Qrist0ph/jiotty_wled_pcb_controller/wled_pcb_controller/README.md

# jiotty_wled_pcb_controller
 
Design based on [https://github.com/klein0r/pcb-ws2812-wifi-controller](https://github.com/klein0r/pcb-ws2812-wifi-controller)
