Qrist0ph/jiotty_wled_pcb_controller/jiottywledtscew/3D1.png

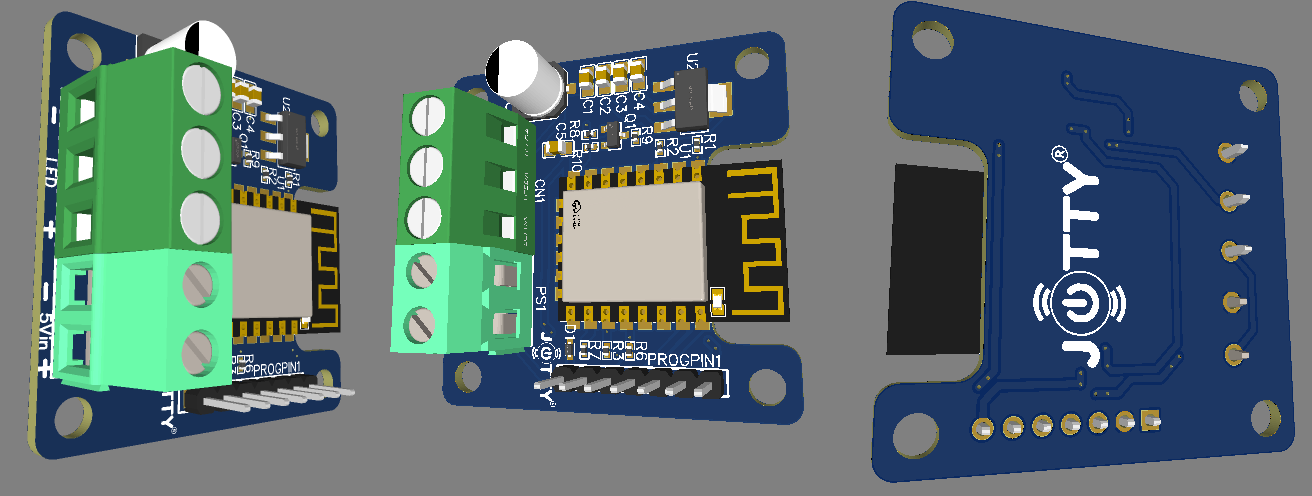
jiottywledtscew/3D1.png
