Qrist0ph/jiotty_wled_pcb_controller/jiottywledusb/3D2.png

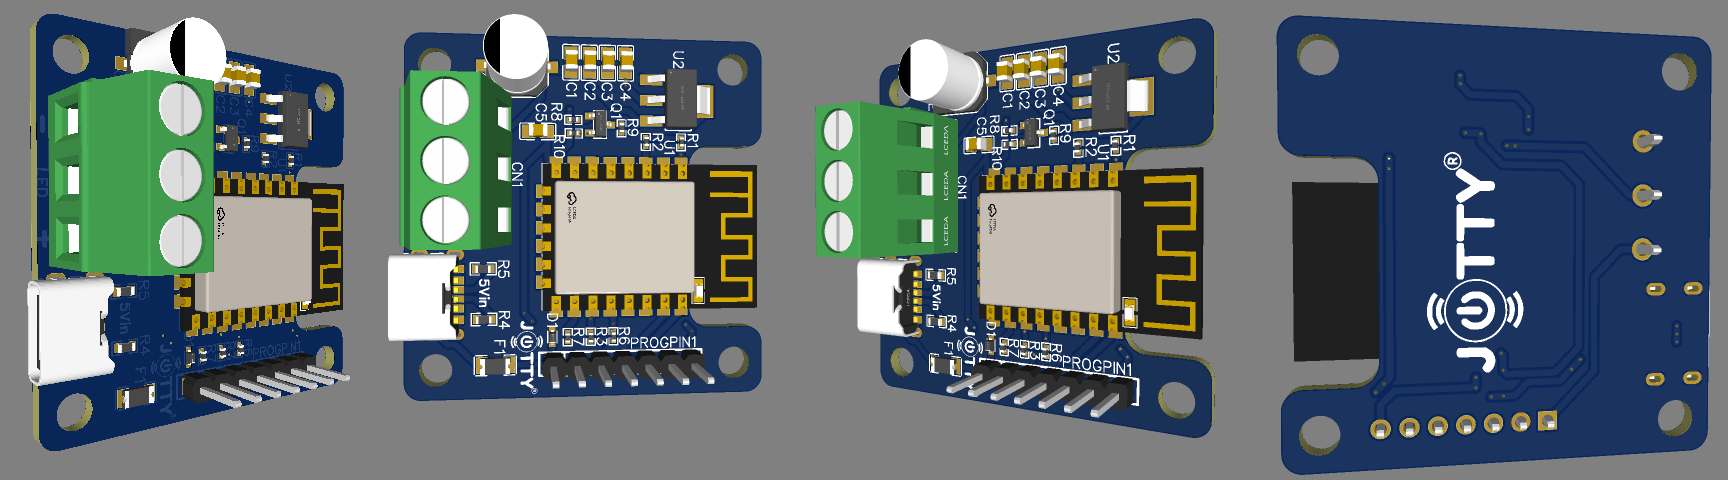
jiottywledusb/3D2.png
