Qrist0ph/jiotty_wled_pcb_controller/jiottywledusb/BOM_PCB_qrist0pf_Proj3_LED_USBScrew_2023-04-06.csv

ID | Name | Designator | Footprint | Quantity | Manufacturer Part | Manufacturer | Supplier | Supplier Part | Price
1 | JK-NSMD200/6V | F1 | F1206 | 1 | JK-nSMD200/6V | JK(金科) | LCSC | C2830251 | 0.006
2 | 5.1kΩ | R4,R5 | R0603 | 2 | 0603WAF5101T5E | UNI-ROYAL(厚声) | LCSC | C23186
3 | TYPE-C-31-M-17 | USB1 | USB-C-SMD_10P-P1.00-L6.8-W8.9 | 1 | TYPE-C-31-M-17 | 韩国韩荣 | LCSC | C283540 | 0.035
4 | WJ500V-5.08-3P-14-00A | CN1 | CONN-TH_3P-P5.00_WJ500V-5.08-3P | 1 | WJ500V-5.08-3P | KANGNEX(康奈克斯电气) | LCSC | C72334 | 0.026
5 | MMBT5551 | Q1 | SOT-23-3_L2.9-W1.3-P1.90-LS2.4-BR | 1 | MMBT5551 | CJ | LCSC | C2145 | 0.002
6 | 1kΩ | R8 | R0402 | 1 | 0402WGF1001TCE | UniOhm | LCSC | C11702
7 | 10kΩ | R9,R10 | R0402 | 2 | 0402WGF1002TCE | UniOhm | LCSC | C25744
8 | 47uF | C1,C3 | C0805 | 2 | CL21A476MQYNNNE | SAMSUNG(三星) | LCSC | C16780 | 0.004
9 | 100nF | C2,C4,C5 | C0805 | 3 | CC0805KRX7R9BB104 | YAGEO | LCSC | C49678 | 0.001
10 | 220uF | CE1 | CAP-SMD_BD6.3-L6.6-W6.6-LS7.2-FD | 1 | RVT1A221M0607 | HONOR | LCSC | C87859 | 0.008
11 | LESD5D5.0CT1G | D1 | SOD-523_L1.2-W0.8-LS1.6-BI | 1 | LESD5D5.0CT1G | Leshan Radio | LCSC | C383211 | 0.003
12 | PZ254V-11-07P | PROGPIN1 | HDR-TH_7P-P2.54-V-M | 1 | PZ254V-11-07P | XFCN(兴飞) | LCSC | C492406 | 0.006
13 | 10kΩ | R1,R2,R3,R6,R7 | R0402 | 5 | 0402WGF1002TCE | UNI-ROYAL(厚声) | LCSC | C25744
14 | 2.4GHz | U1 | WIFIM-SMD_ESP-12F-ESP8266MOD | 1 | ESP-12F(ESP8266MOD) | Ai-Thinker(安信可) | LCSC | C82891 | 0.361
15 | AMS1117-3.3 | U2 | SOT-223-3_L6.5-W3.4-P2.30-LS7.0-BR | 1 | AMS1117-3.3 | AMS | LCSC | C6186 | 0.024
