Qrist0ph/jiotty_wled_pcb_controller/jiottywledusb/PCB_qrist0pf_Proj3_LED_USBScrew_2023-04-06.dxf

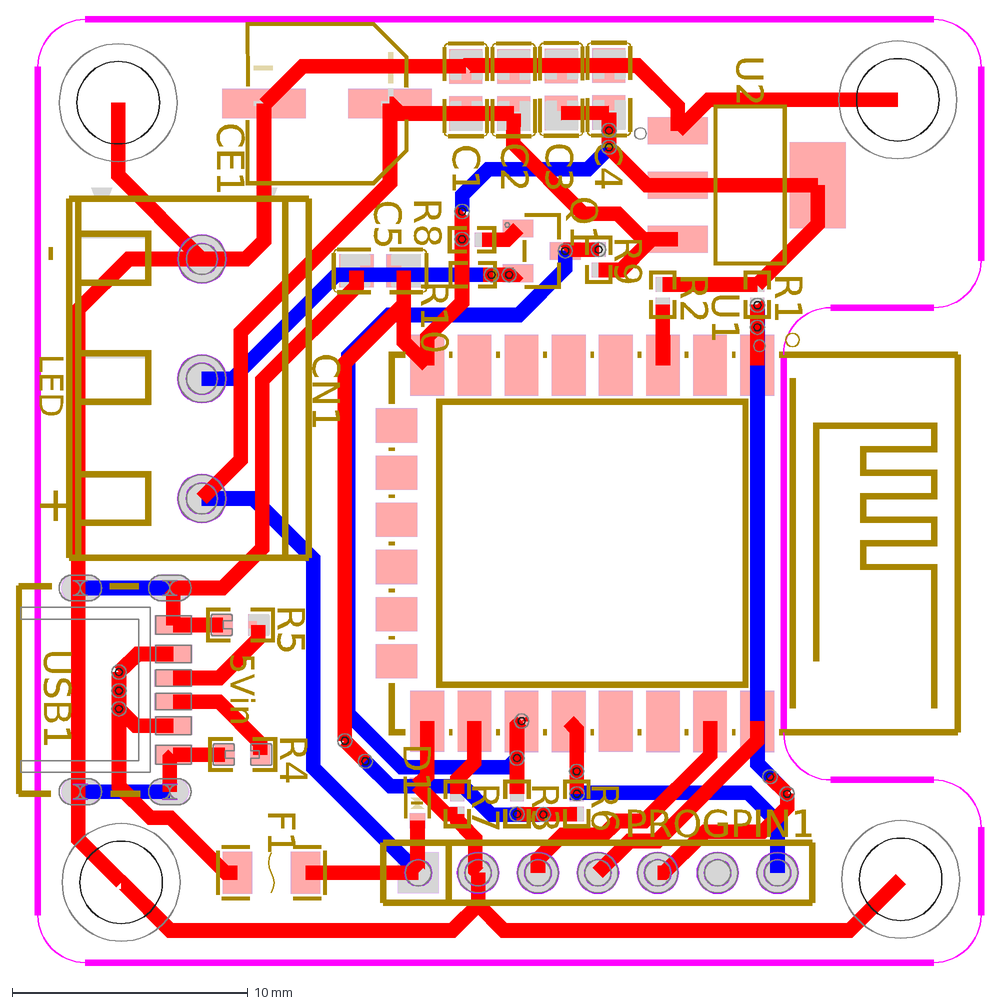
[picture p5: CAD file, 2023-05-03]
jiottywledusb/PCB_qrist0pf_Proj3_LED_USBScrew_2023-04-06.dxf
-
LED
+
5Vin
F1
R4
R5
USB1
CN1
Q1
R8
R9
R10
C1
C2
C3
C4
C5
CE1
D1
PROGPIN1
R1
R2
R3
R6
R7
U1
U2
