Qrist0ph/jiotty_wled_pcb_controller/jiottywledtscew/Schematic_qrist0pf_Proj3_LED_2023-04-06.pdf

## Resettable FUSE 2.0A

2 | OR

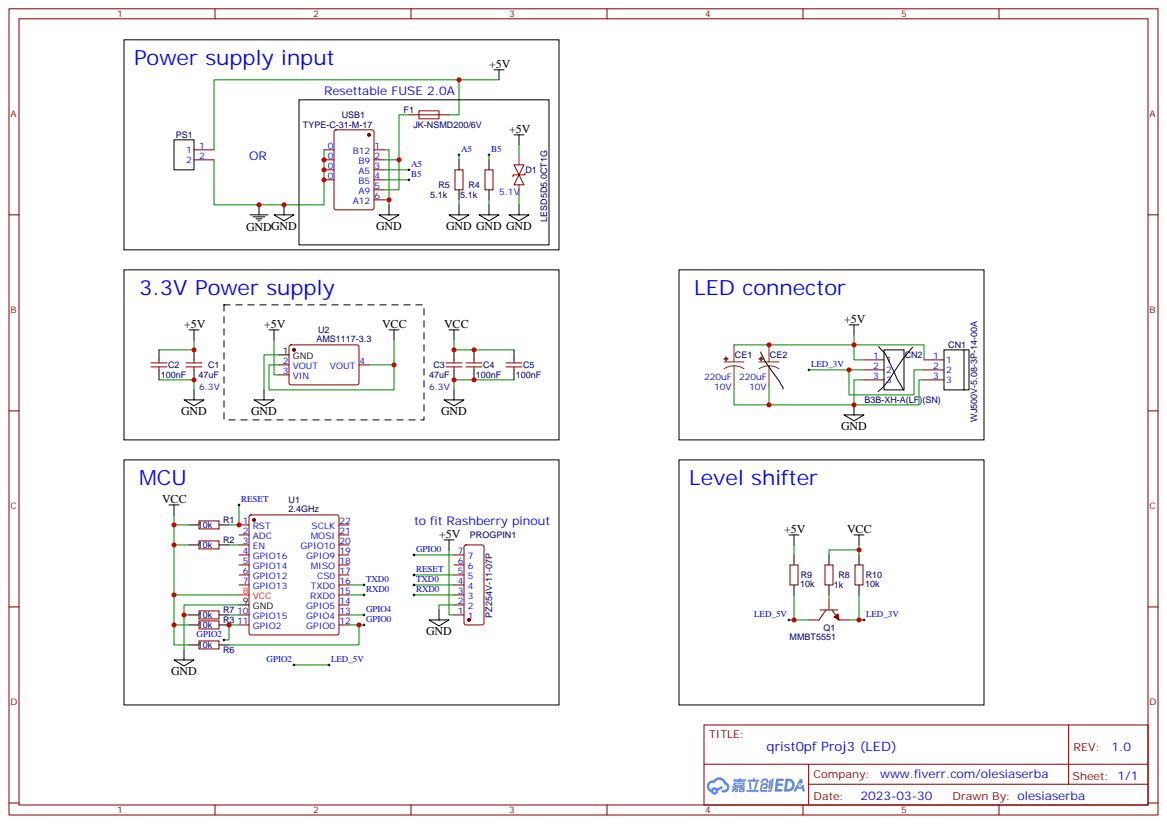
[picture p6: page 1]

Company: www.fiverr.com/olesiaserba
