Qrist0ph/jiotty_wled_pcb_controller/jiottywledtscew/PCB_PCB_qrist0pf_Proj3_LED_ScrewScrew_2023-04-06.pdf

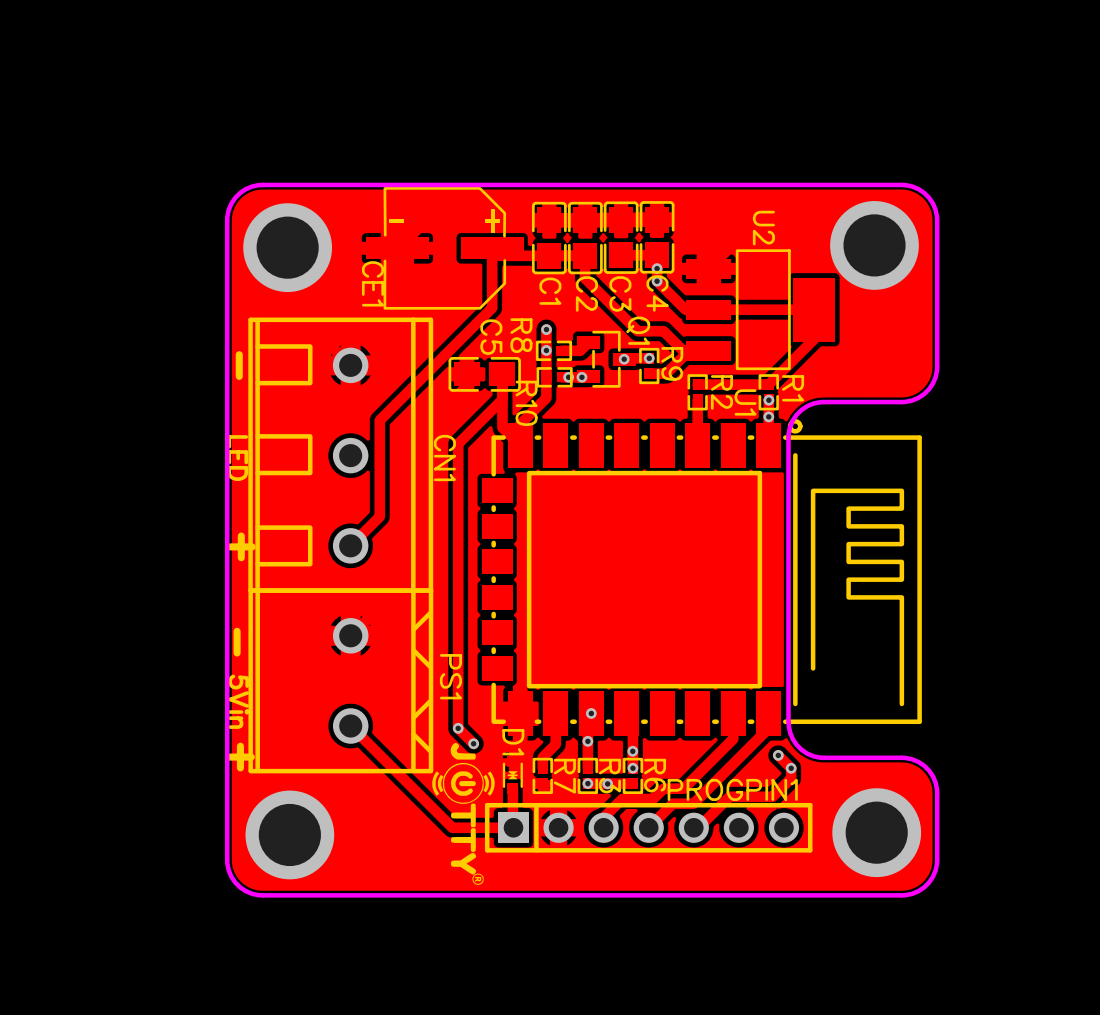
[picture p7: page 1]
