Qrist0ph/jiotty_wled_pcb_controller/jiottywledusb/PCB_PCB_qrist0pf_Proj3_LED_USBScrew_2023-04-06 (1).pdf

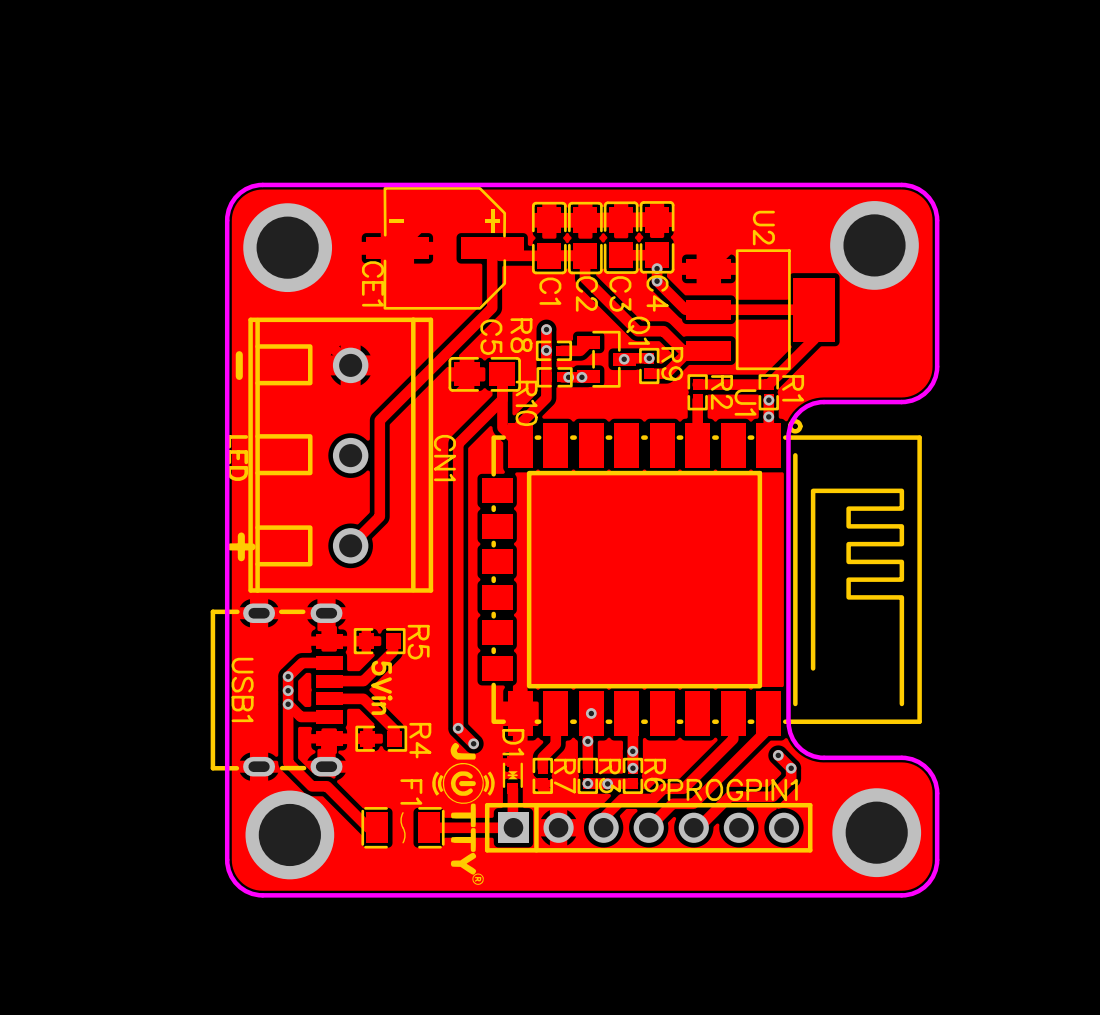
[picture p9: page 1]
