Qrist0ph/jiotty_wled_pcb_controller/jiottywledusb/PCB_PCB_qrist0pf_Proj3_LED_USBScrew_2023-04-06 (2).pdf

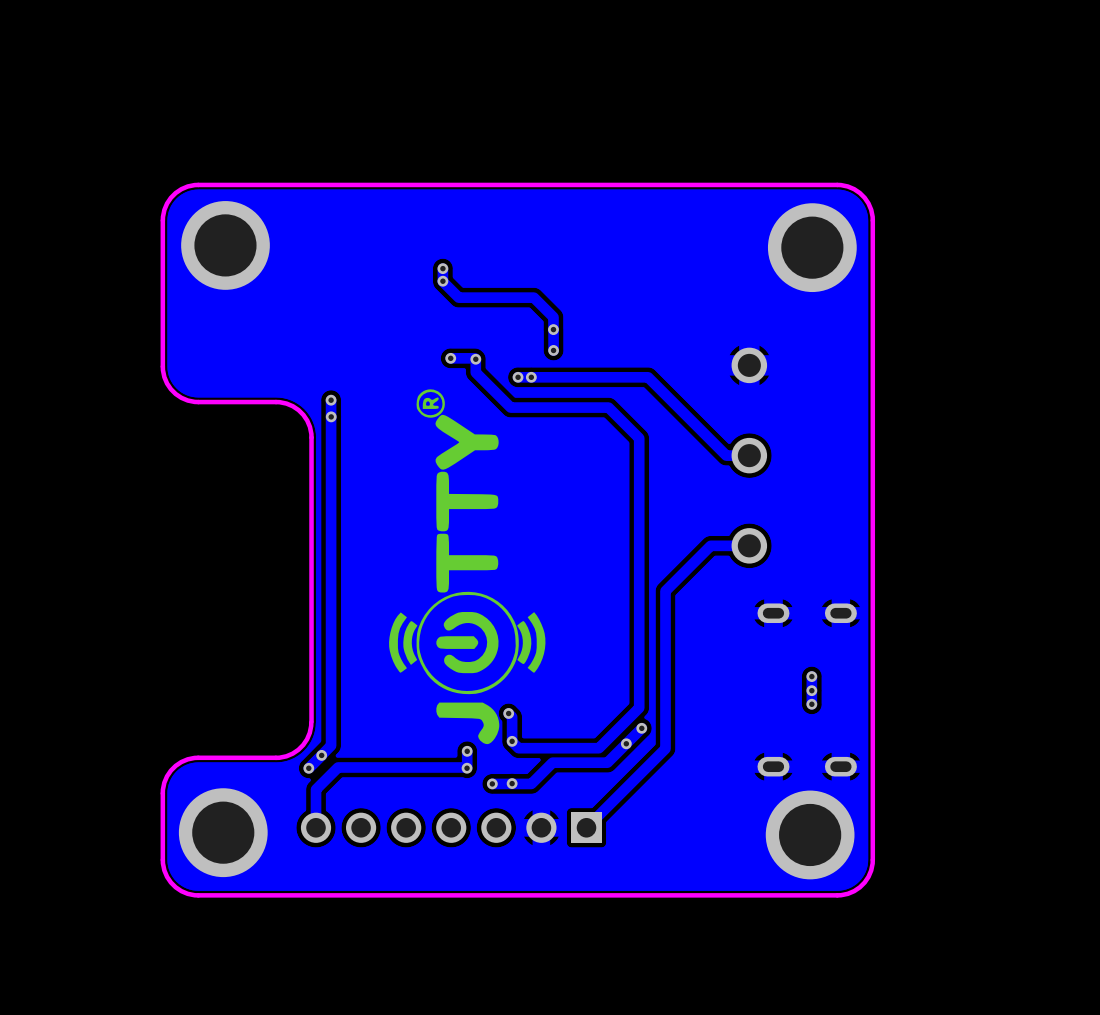
[picture p10: page 1]
