Qrist0ph/jiotty_wled_pcb_controller/(list of files, drawings)

Other design files:
jiottywledtscew/PCB_PCB_qrist0pf_Proj3_LED_ScrewScrew_2023-04-06 (1).json
jiottywledtscew/SCH_qrist0pf_Proj3_LED_2023-04-06.json
jiottywledusb/PCB_PCB_qrist0pf_Proj3_LED_USBScrew_2023-04-06.json
jiottywledusb/SCH_qrist0pf_Proj3_LED_2023-04-06.json
