Qrist0ph/jiotty_wled_pcb_controller/wled_pcb_controller/pcbdesign/pcb-ws2812-wifi-controller-master/WS2812Controller.kicad_pcb

## KiCad design wled_pcb_controller/pcbdesign/pcb-ws2812-wifi-controller-master/WS2812Controller.kicad_pcb (2023-03-26)

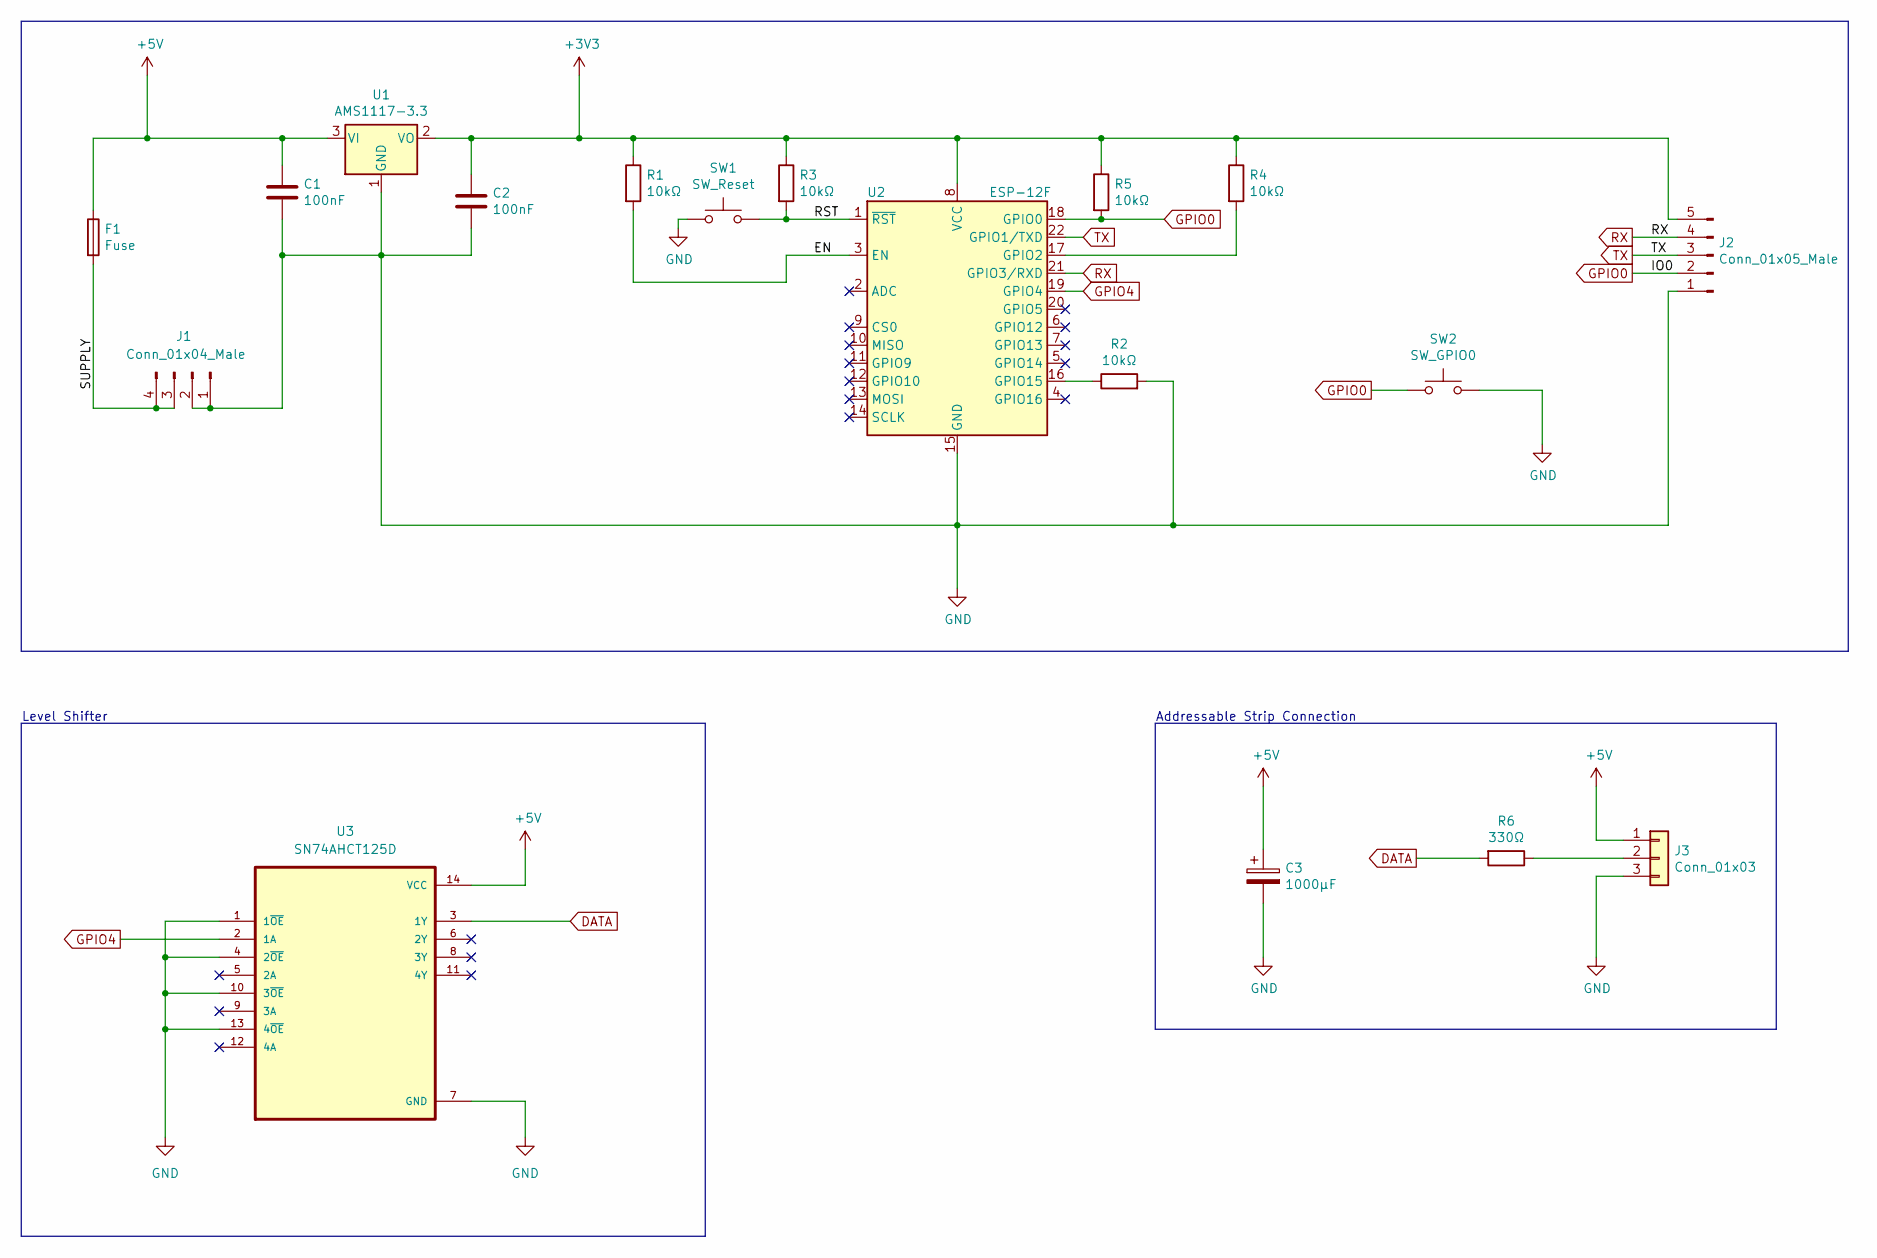
[picture p11: schematic WS2812Controller.kicad_sch, WS2812 Controller]

Parts:
C1, C2: 100nF; C_0805_2012Metric; JLCPCB Part # C495959
C3: 1000µF; CP_Radial_D8.0mm_P3.50mm; JLCPCB Part # C189254
F1: Fuse; PTF_77; JLCPCB Part # C717030
J1: Conn_01x04_Male; TerminalBlock_Phoenix_MPT-0,5-4-2.54_1x04_P2.54mm_Horizontal; JLCPCB Part # C474922
J2: Conn_01x05_Male; PinHeader_1x05_P2.54mm_Vertical; JLCPCB Part # C5156614
J3: Conn_01x03; TerminalBlock_Phoenix_MPT-0,5-3-2.54_1x03_P2.54mm_Horizontal; JLCPCB Part # C474921
R1, R2, R3, R4, R5: 10kΩ; R_0805_2012Metric; JLCPCB Part # C416062
R6: 330Ω; R_0805_2012Metric; JLCPCB Part # C328393
SW1: SW_Reset; SW_Push_1P1T_NO_CK_KMR2; JLCPCB Part # C72443
SW2: SW_GPIO0; SW_Push_1P1T_NO_CK_KMR2; JLCPCB Part # C72443
U1: AMS1117-3.3; SOT-223-3_TabPin2; JLCPCB Part # C6186
U2: ESP-12F; ESP-12E; JLCPCB Part # C82891
U3: SN74AHCT125D; JLCPCB Part # C155176

Connections:
+3V3: C2.1, J2.5, R1.1, R3.1, R4.1, R5.1, U1.2 (VO), U2.8 (VCC)
+5V: C1.1, C3.1, F1.1, J3.1, U1.3 (VI), U3.14 (VCC)
/EN: R1.2, U2.3 (EN)
/RST: R3.2, SW1.2, U2.1 (~RST)
/SUPPLY: F1.2, J1.3, J1.4
DATA: R6.2, U3.3 (1Y)
GND: C1.2, C2.2, C3.2, J1.1, J1.2, J2.1, J3.3, R2.2, SW1.1, SW2.2, U1.1 (GND), U2.15 (GND), U3.1 (1~OE), U3.4 (2~OE), U3.7 (GND), U3.10 (3~OE), U3.13 (4~OE)
GPIO0: J2.2, R5.2, SW2.1, U2.18 (GPIO0)
GPIO4: U2.19 (GPIO4), U3.2 (1A)
unnamed: J3.2, R6.1
unnamed: R2.1, U2.16 (GPIO15)
unnamed: R4.2, U2.17 (GPIO2)
RX: J2.4, U2.21 (GPIO3/RXD)
TX: J2.3, U2.22 (GPIO1/TXD)

Notes on the sheet:
Addressable Strip Connection
Level Shifter

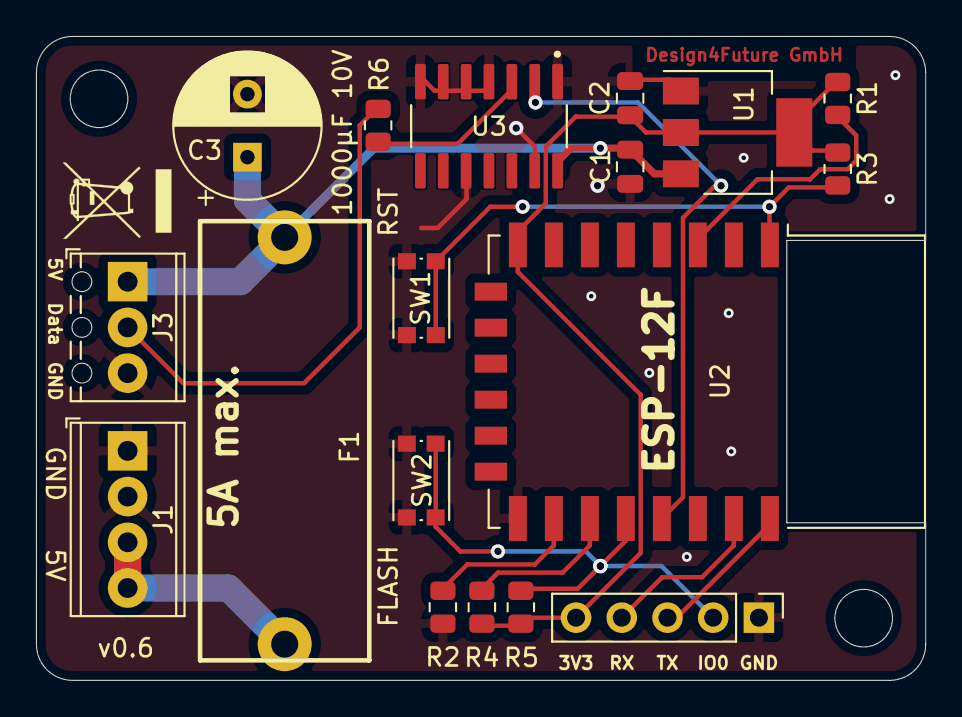
[picture p12: board WS2812Controller.kicad_pcb from above]

Board: 2 copper layers, 49.4 x 35.8 mm, 18 parts (0 on the bottom side), 14 nets.
