Qrist0ph/jiotty_wled_pcb_controller/jiottywledusb/gerber/How-to-order-PCB.txt

How to Order PCB

Please refer to:
https://docs.easyeda.com/en/PCB/Order-PCB
