Qrist0ph/jiotty_wled_pcb_controller/(commit log)

2023-03-26 Initials commit
    [BOM.csv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]
2023-05-03 olesia wled files
    [BOM.csv, BOM_PCB_qrist0pf_Proj3_LED_ScrewScrew_2023-04-06.csv, BOM_PCB_qrist0pf_Proj3_LED_USBScrew_2023-04-06.csv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]
